angelaAceroh/Robotica-2026/Ensabladores/Ensamblador 3 /Electrónica/Diagrama_montaje_electrico.jpeg

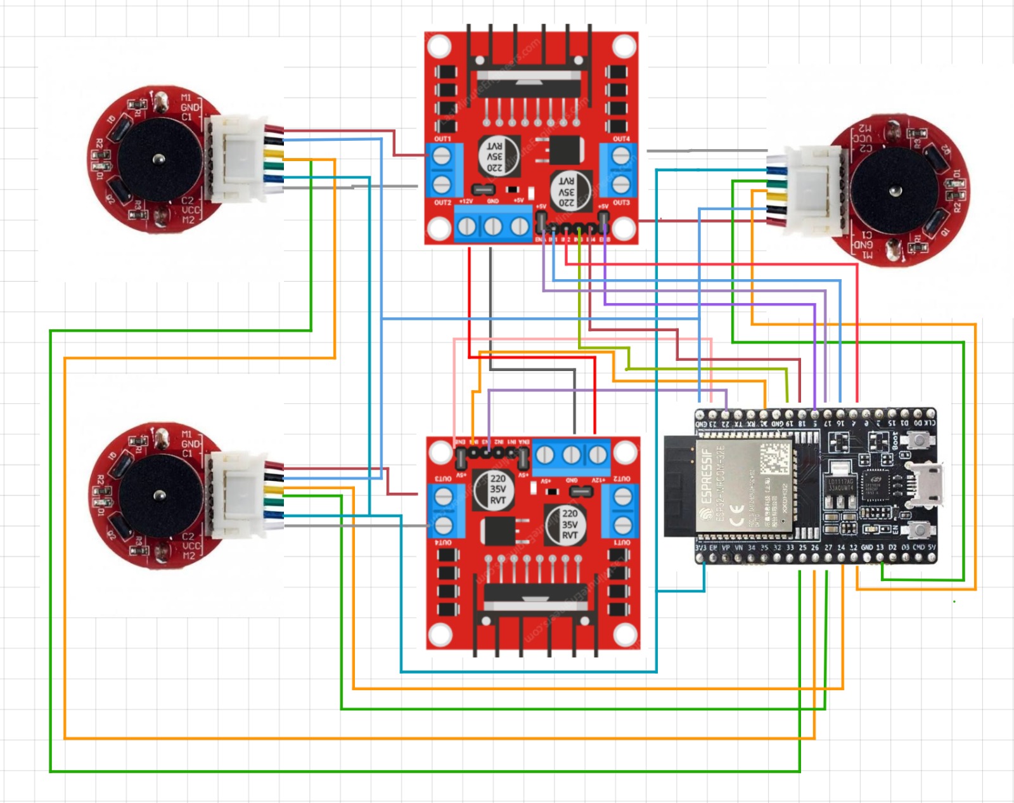
Ensabladores/Ensamblador 3 /Electrónica/Diagrama_montaje_electrico.jpeg
