angelaAceroh/Robotica-2026/Ensabladores/Ensamblador 2/SCARA/Documentacion/DIAGRAMAS/1)DIAGRAMA INDIVIDUAL.jpeg

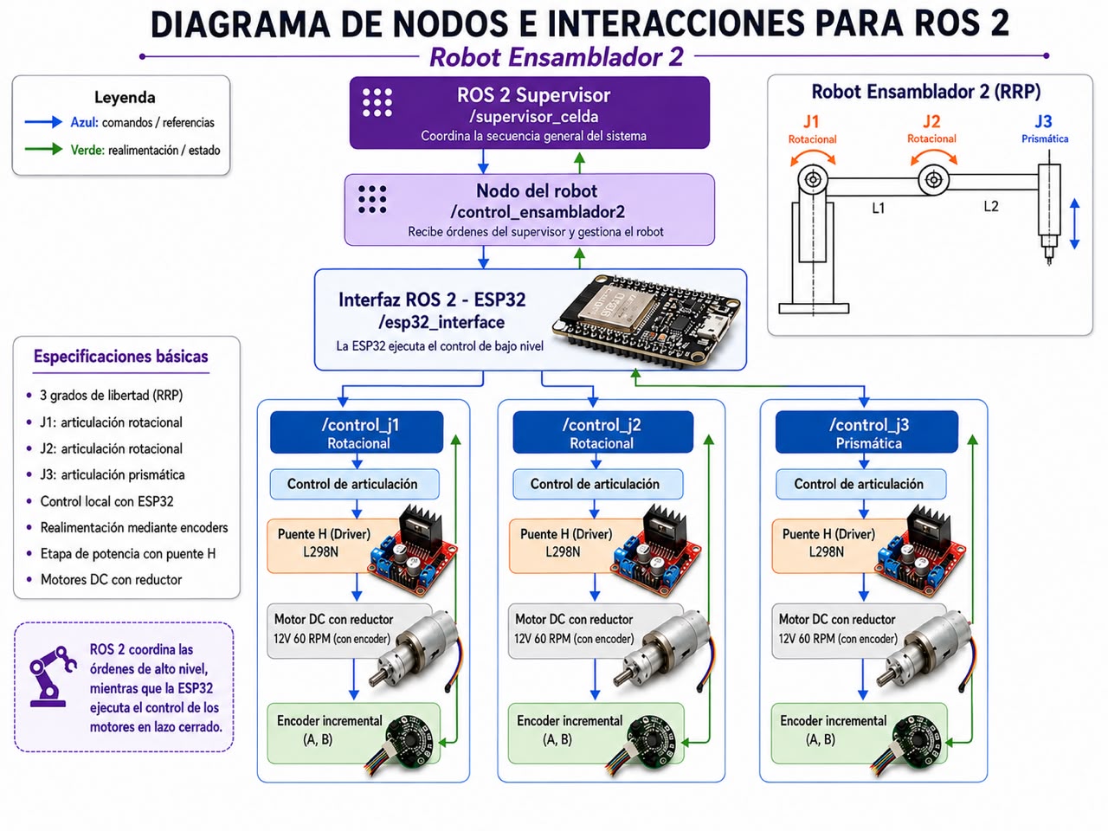
Ensabladores/Ensamblador 2/SCARA/Documentacion/DIAGRAMAS/1)DIAGRAMA INDIVIDUAL.jpeg
