angelaAceroh/Robotica-2026/README.md

# Robotica-2026
Info de la plata de robótica 2026-2
