angelaAceroh/Robotica-2026/Ensabladores/Ensamblador 1/EnsamblajeURDF/meshes/Gripper_Link.STL

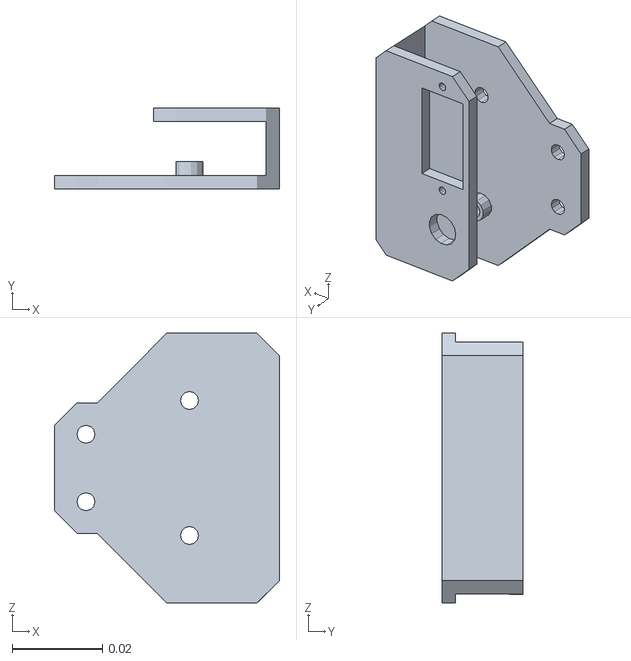
[picture p17: CAD file, 2026-10-02]
Ensabladores/Ensamblador 1/EnsamblajeURDF/meshes/Gripper_Link.STL
0.05 x 0.0181 x 0.06
