angelaAceroh/Robotica-2026/Ensabladores/Ensamblador 3 /Software/src/scara_urdf/meshes/Simon.STL

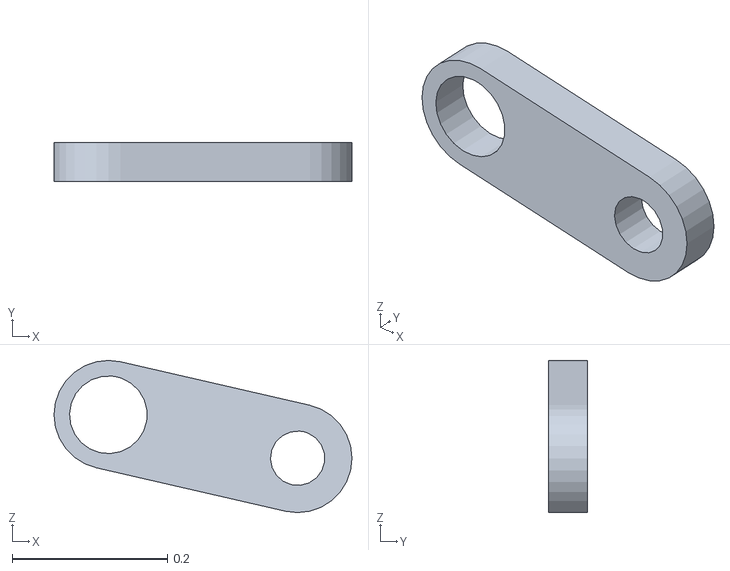
[picture p18: CAD file, 2026-10-02]
Ensabladores/Ensamblador 3 /Software/src/scara_urdf/meshes/Simon.STL
0.384 x 0.05 x 0.196
