angelaAceroh/Robotica-2026/Ensabladores/Ensamblador 1/EnsamblajeURDF/meshes/sopoizquierdo_Link.STL

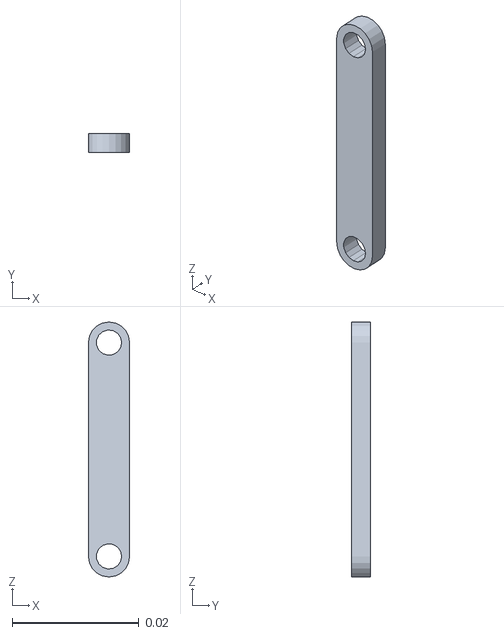
[picture p19: CAD file, 2026-10-02]
Ensabladores/Ensamblador 1/EnsamblajeURDF/meshes/sopoizquierdo_Link.STL
0.0065 x 0.003 x 0.0403
