angelaAceroh/Robotica-2026/Ensabladores/Ensamblador 3 /Mecánica/Simon1.SLDPRT

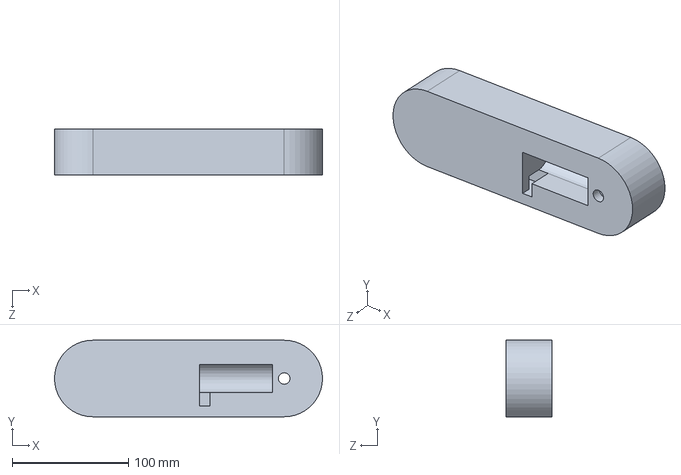
[picture p20: CAD file, 2026-08-21]
Ensabladores/Ensamblador 3 /Mecánica/Simon1.SLDPRT
231.0 x 66.0 x 40.0 mm
