angelaAceroh/Robotica-2026/Ensabladores/Ensamblador 3 /Software/src/scara_urdf/meshes/Teodoro.STL

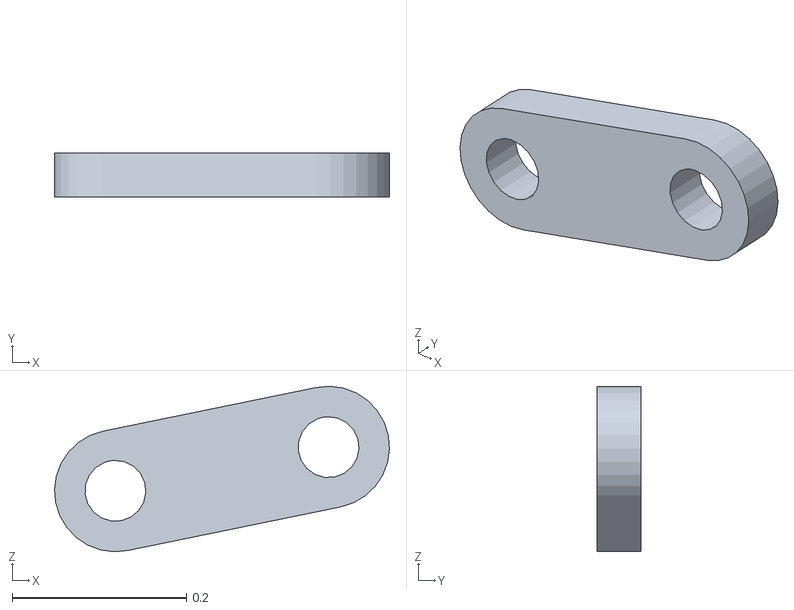
[picture p21: CAD file, 2026-10-02]
Ensabladores/Ensamblador 3 /Software/src/scara_urdf/meshes/Teodoro.STL
0.385 x 0.05 x 0.19
