angelaAceroh/Robotica-2026/Ensabladores/Ensamblador 1/EnsamblajeURDF/meshes/Eje_Principal_link.STL

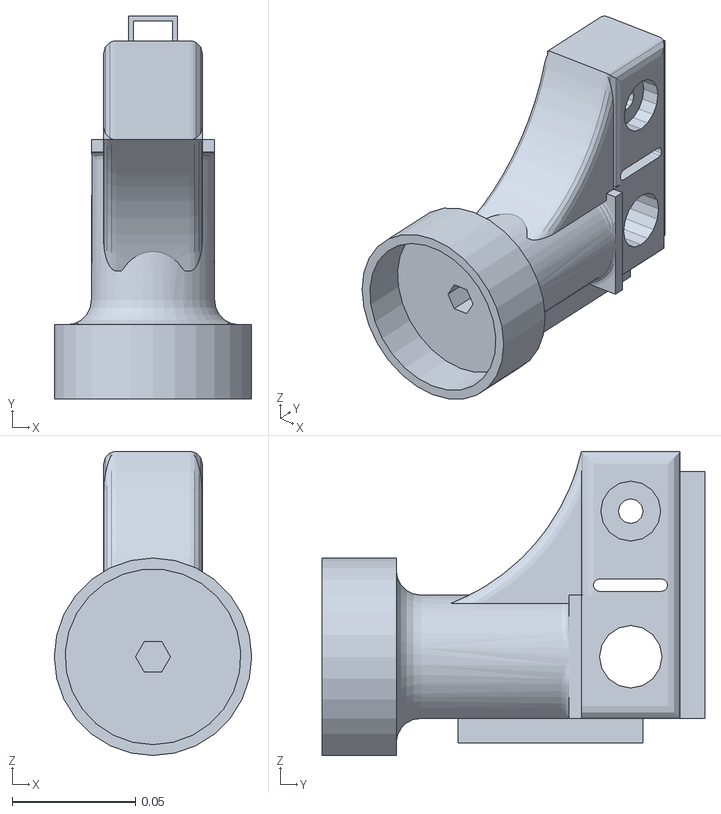
[picture p22: CAD file, 2026-10-02]
Ensabladores/Ensamblador 1/EnsamblajeURDF/meshes/Eje_Principal_link.STL
0.08 x 0.155 x 0.123
