angelaAceroh/Robotica-2026/Ensabladores/Ensamblador 3 /Mecánica/Teodoro1.SLDPRT

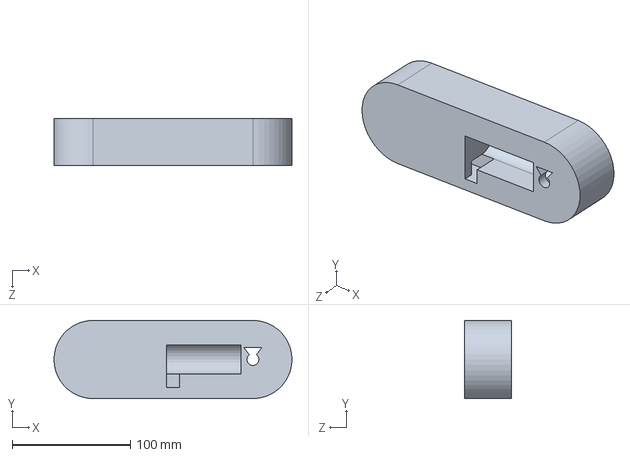
[picture p23: CAD file, 2026-08-21]
Ensabladores/Ensamblador 3 /Mecánica/Teodoro1.SLDPRT
201.0 x 66.0 x 40.0 mm
