angelaAceroh/Robotica-2026/Ensabladores/Ensamblador 3 /Software/src/scara_urdf/meshes/Dave.STL

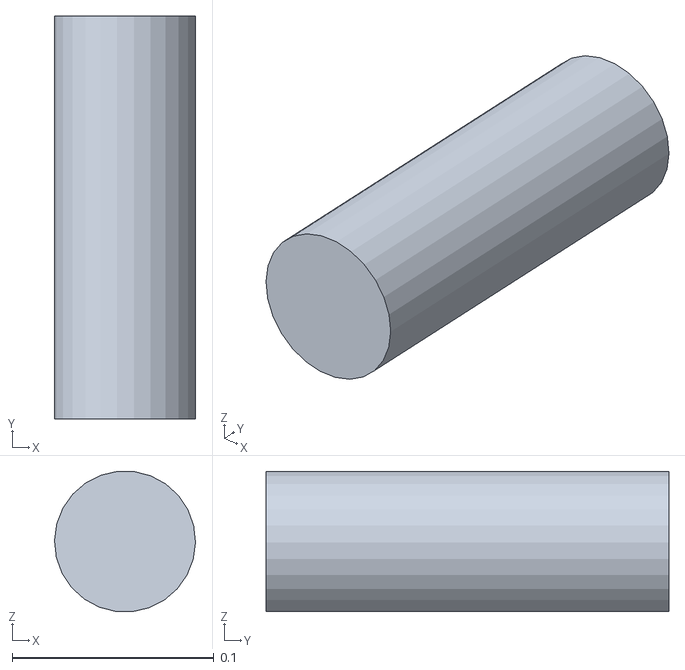
[picture p24: CAD file, 2026-10-02]
Ensabladores/Ensamblador 3 /Software/src/scara_urdf/meshes/Dave.STL
0.07 x 0.2 x 0.0696
