angelaAceroh/Robotica-2026/Ensabladores/Ensamblador 1/EnsamblajeURDF/meshes/Engraizquierdo_Link.STL

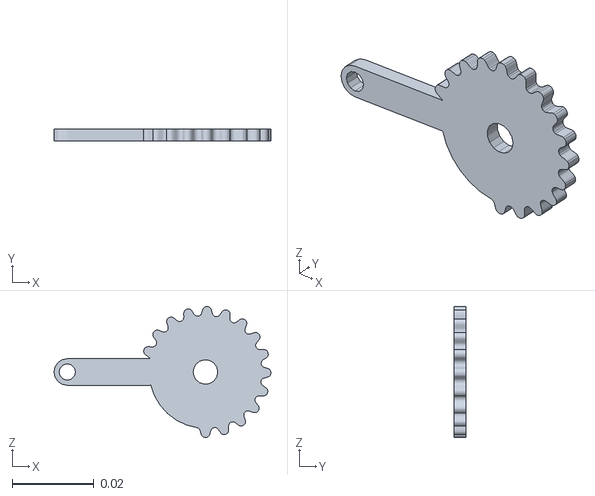
[picture p25: CAD file, 2026-10-02]
Ensabladores/Ensamblador 1/EnsamblajeURDF/meshes/Engraizquierdo_Link.STL
0.053 x 0.003 x 0.032
