angelaAceroh/Robotica-2026/Ensabladores/Ensamblador 3 /Mecánica/Dave1.SLDPRT

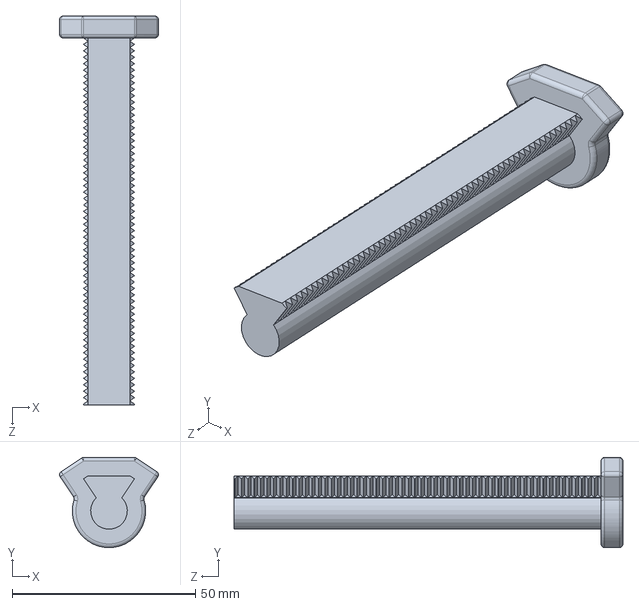
[picture p26: CAD file, 2026-08-21]
Ensabladores/Ensamblador 3 /Mecánica/Dave1.SLDPRT
27.0 x 24.6 x 106.0 mm
