angelaAceroh/Robotica-2026/Ensabladores/Ensamblador 3 /Software/src/scara_urdf/meshes/Ian.STL

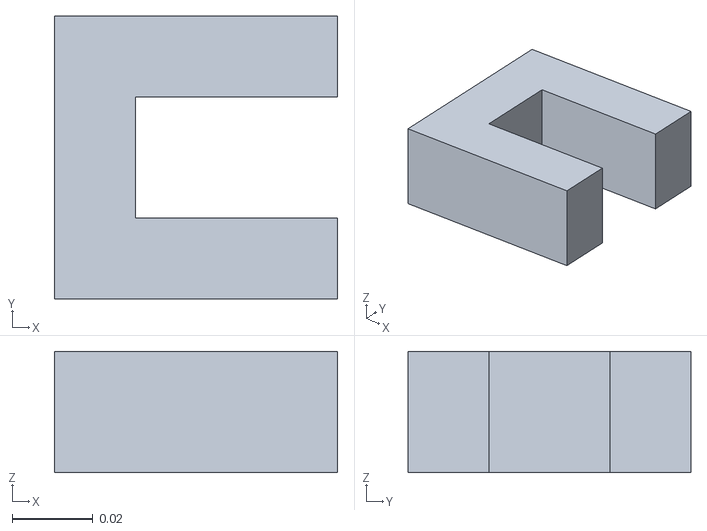
[picture p27: CAD file, 2026-10-02]
Ensabladores/Ensamblador 3 /Software/src/scara_urdf/meshes/Ian.STL
0.07 x 0.07 x 0.03
