angelaAceroh/Robotica-2026/Ensabladores/Ensamblador 1/EnsamblajeURDF/meshes/braerecho_Link.STL

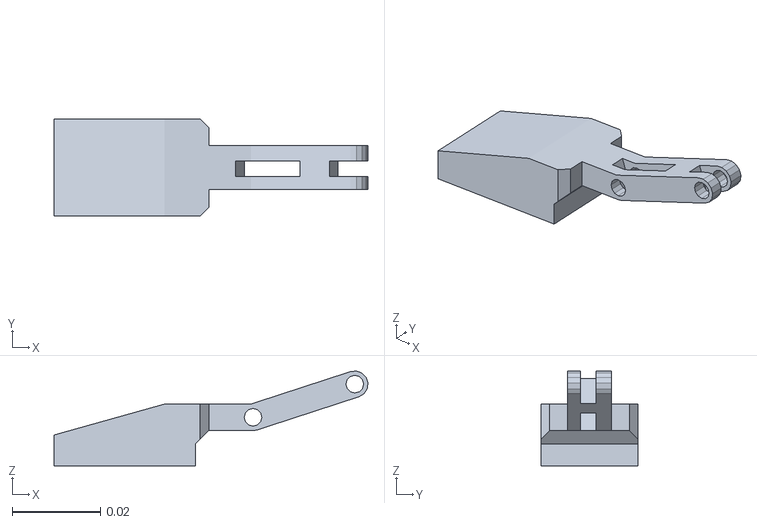
[picture p28: CAD file, 2026-10-02]
Ensabladores/Ensamblador 1/EnsamblajeURDF/meshes/braerecho_Link.STL
0.071 x 0.022 x 0.0215
