angelaAceroh/Robotica-2026/Ensabladores/Ensamblador 3 /Mecánica/tapa electronica.SLDPRT

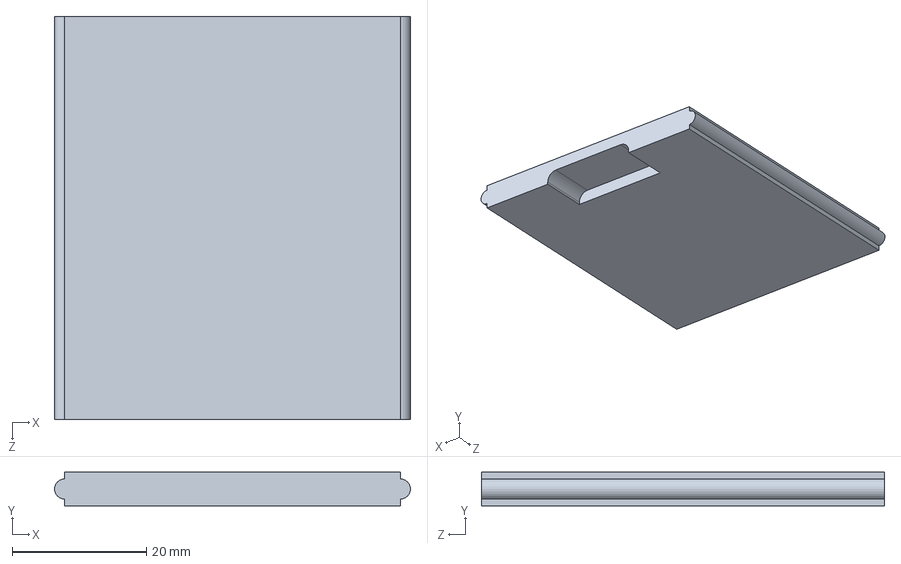
[picture p29: CAD file, 2026-08-21]
Ensabladores/Ensamblador 3 /Mecánica/tapa electronica.SLDPRT
53.0 x 5.00 x 60.0 mm
