angelaAceroh/Robotica-2026/Ensabladores/Ensamblador 3 /Software/src/scara_urdf/meshes/Alvin.STL

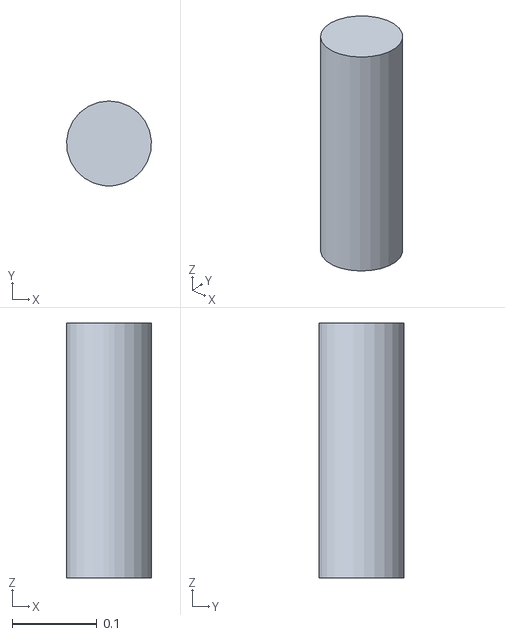
[picture p30: CAD file, 2026-10-02]
Ensabladores/Ensamblador 3 /Software/src/scara_urdf/meshes/Alvin.STL
0.0998 x 0.1 x 0.3
