angelaAceroh/Robotica-2026/Ensabladores/Ensamblador 3 /Mecánica/Alvin1.SLDPRT

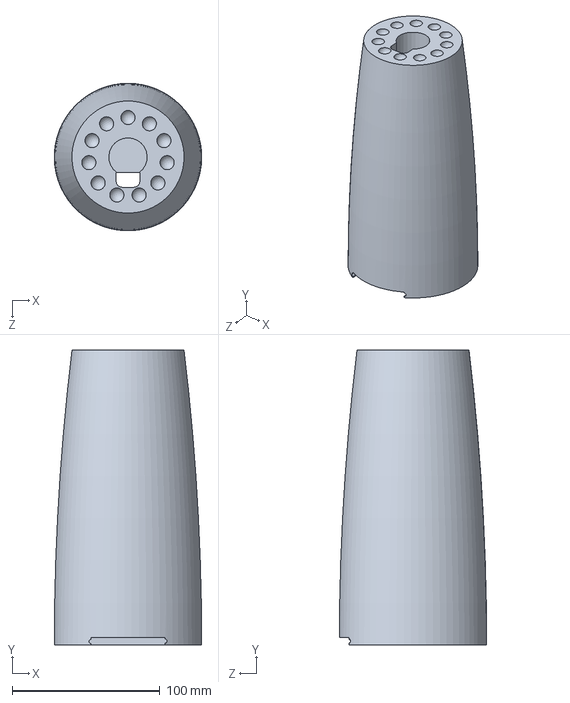
[picture p32: CAD file, 2026-08-21]
Ensabladores/Ensamblador 3 /Mecánica/Alvin1.SLDPRT
100.0 x 200.0 x 99.9 mm
