angelaAceroh/Robotica-2026/Ensabladores/Ensamblador 1/EnsamblajeURDF/meshes/Eje_largo_link.STL

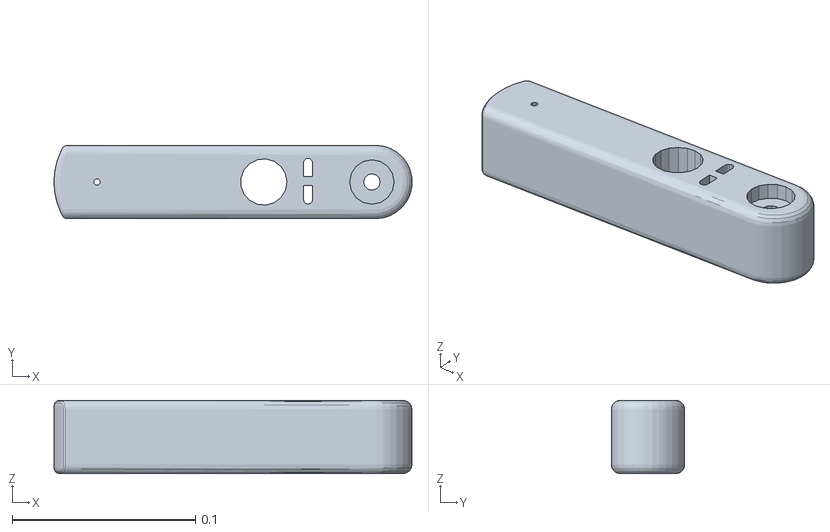
[picture p33: CAD file, 2026-10-02]
Ensabladores/Ensamblador 1/EnsamblajeURDF/meshes/Eje_largo_link.STL
0.195 x 0.04 x 0.04
