angelaAceroh/Robotica-2026/Ensabladores/Ensamblador 1/EnsamblajeURDF/meshes/Eje_final_link.STL

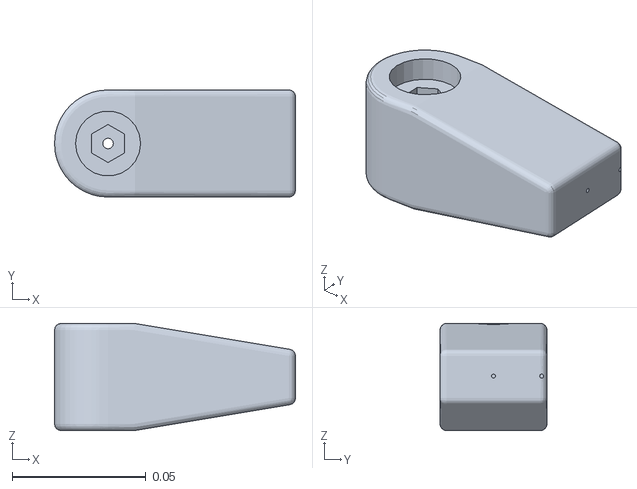
[picture p34: CAD file, 2026-10-02]
Ensabladores/Ensamblador 1/EnsamblajeURDF/meshes/Eje_final_link.STL
0.09 x 0.04 x 0.04
