angelaAceroh/Robotica-2026/Ensabladores/Ensamblador 3 /Mecánica/Ensamblaje1.SLDASM

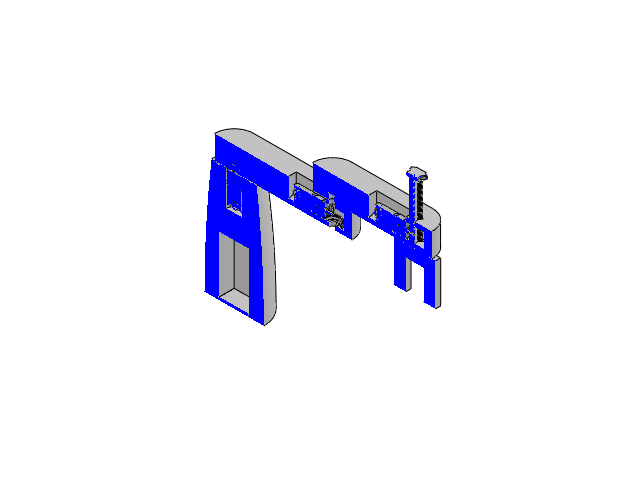
[picture p35: CAD file, 2026-08-21]
Ensabladores/Ensamblador 3 /Mecánica/Ensamblaje1.SLDASM
Alvin1
tapa electronica
JGA25-370 - JGA25-370 x 3
Teodoro1
Simon1
engranajeMotorGrua2Ext
Dave1
