angelaAceroh/Robotica-2026/(list of files, cad)

Other CAD files:
Ensabladores/Ensamblador 1/EnsamblajeURDF/meshes/Engraderecho_Link.STL
Ensabladores/Ensamblador 1/EnsamblajeURDF/meshes/sopoderecho_Link.STL
Ensabladores/Ensamblador 1/EnsamblajeURDF/meshes/braizquierdo_Link.STL
Ensabladores/Ensamblador 3 /Mecánica/Ensamblaje1 - copia.SLDDRW
Ensabladores/Ensamblador 3 /Mecánica/Ensamblaje1.SLDDRW
