angelaAceroh/Robotica-2026/Ensabladores/Ensamblador 3 /Software/README

En esta carpeta se encuentra tdod el material relacionado al uso de ROS, GAZEBO, y comunaciocon entre los ndos, asi como la interfaz y los diagramas.
