angelaAceroh/Robotica-2026/Ensabladores/Ensamblador 3 /Mecánica/README

En esta carpeta se encuentra todo el material con respecto a la mecánica y distribucon del robot
