angelaAceroh/Robotica-2026/Ensabladores/Ensamblador 3 /Software/build/scara_urdf/install_manifest.txt

/home/sergio/ros2_ws/install/scara_urdf/share/scara_urdf/config/joint_names_scara_urdf.yaml
/home/sergio/ros2_ws/install/scara_urdf/share/scara_urdf/launch/gazebo.launch.py
/home/sergio/ros2_ws/install/scara_urdf/share/scara_urdf/launch/display.launch.py
/home/sergio/ros2_ws/install/scara_urdf/share/scara_urdf/meshes/Ian.STL
/home/sergio/ros2_ws/install/scara_urdf/share/scara_urdf/meshes/Dave.STL
/home/sergio/ros2_ws/install/scara_urdf/share/scara_urdf/meshes/Alvin.STL
/home/sergio/ros2_ws/install/scara_urdf/share/scara_urdf/meshes/Simon.STL
/home/sergio/ros2_ws/install/scara_urdf/share/scara_urdf/meshes/Teodoro.STL
/home/sergio/ros2_ws/install/scara_urdf/share/scara_urdf/rviz/scara.rviz
/home/sergio/ros2_ws/install/scara_urdf/share/scara_urdf/rviz/urdf.rviz
/home/sergio/ros2_ws/install/scara_urdf/share/scara_urdf/urdf/scara_urdf.urdf
/home/sergio/ros2_ws/install/scara_urdf/share/scara_urdf/urdf/scara_urdf_gz.urdf
/home/sergio/ros2_ws/install/scara_urdf/share/scara_urdf/environment/gz_resource_path.dsv
/home/sergio/ros2_ws/install/scara_urdf/share/ament_index/resource_index/package_run_dependencies/scara_urdf
/home/sergio/ros2_ws/install/scara_urdf/share/ament_index/resource_index/parent_prefix_path/scara_urdf
/home/sergio/ros2_ws/install/scara_urdf/share/scara_urdf/environment/ament_prefix_path.sh
/home/sergio/ros2_ws/install/scara_urdf/share/scara_urdf/environment/ament_prefix_path.dsv
/home/sergio/ros2_ws/install/scara_urdf/share/scara_urdf/environment/path.sh
/home/sergio/ros2_ws/install/scara_urdf/share/scara_urdf/environment/path.dsv
/home/sergio/ros2_ws/install/scara_urdf/share/scara_urdf/local_setup.bash
/home/sergio/ros2_ws/install/scara_urdf/share/scara_urdf/local_setup.fish
/home/sergio/ros2_ws/install/scara_urdf/share/scara_urdf/local_setup.sh
/home/sergio/ros2_ws/install/scara_urdf/share/scara_urdf/local_setup.zsh
/home/sergio/ros2_ws/install/scara_urdf/share/scara_urdf/local_setup.dsv
/home/sergio/ros2_ws/install/scara_urdf/share/scara_urdf/package.dsv
/home/sergio/ros2_ws/install/scara_urdf/share/ament_index/resource_index/packages/scara_urdf
/home/sergio/ros2_ws/install/scara_urdf/share/scara_urdf/cmake/scara_urdfConfig.cmake
/home/sergio/ros2_ws/install/scara_urdf/share/scara_urdf/cmake/scara_urdfConfig-version.cmake
/home/sergio/ros2_ws/install/scara_urdf/share/scara_urdf/package.xml
