angelaAceroh/Robotica-2026/Ensabladores/Ensamblador 2/SCARA/Documentacion/Diagrama de nodos/6)DIAGRAMA DE NODOS E INTERACCIONES PARA ROS2.html

# Diagrama de nodos e interacciones para ROS 2 — Ensamblador 2

En esta arquitectura, ROS 2 coordina la celda mediante un nodo supervisor. Para el robot Ensamblador 2, el nivel de alto nivel se integra con el nivel físico: ESP32 para control local, puentes H como etapa de potencia, motores DC con encoder para realimentación y una configuración mecánica RRP de 3 grados de libertad. Las dimensiones mostradas se actualizaron con el plano mecánico definitivo.

Nodo central: /supervisor_celda Comandos: supervisor → robot Estados: robot → supervisor

### Especificaciones clave de E2

- 3 GDL tipo RRP: J1 rotacional, J2 rotacional, J3 prismática.
- Control local mediante ESP32.
- Realimentación mediante encoders de los motores.
- Etapa de potencia mediante puente H.
- Longitud total en planta: 489,97 mm.
- Altura máxima en vista lateral: 288,50 mm.
- Ancho frontal de base: 140,00 mm.
- Plano: A3 · escala 1:5 · cotas en mm.

## Arquitectura ROS 2 de la celda

Haz clic sobre cualquier nodo para ver su función, mensajes e interacción. El nodo de E2 fue ampliado con su arquitectura interna de control y hardware.

/supervisor_celda

Nodo Supervisor Central · Coordina toda la secuencia

Orden / comando Estado / confirmación

T1

### /nodo_t1

Transportador 1
P0 → P1 → P2

/t1/comando

/t1/estado

E1

### /nodo_e1

Ensamblador 1
Opera en P1

/e1/comando

/e1/estado

E2

### /nodo_e2

Ensamblador 2
Opera en P2 · RRP 3 GDL

/e2/comando

/e2/estado

T2

### /nodo_t2

Transportador 2
P2 → P3 → P4

/t2/comando

/t2/estado

E3

### /nodo_e3

Ensamblador 3
Opera en P3

/e3/comando

/e3/estado

Supervisor → Robots

publica órdenes en /t1/comando/e1/comando/e2/comando/t2/comando/e3/comando

Robots → Supervisor

publican estados en /t1/estado/e1/estado/e2/estado/t2/estado/e3/estado

## Arquitectura interna del Ensamblador 2

Configuración mecánica correcta: RRP — J1 rotacional, J2 rotacional y J3 prismática.

En E2, ROS 2 define la tarea y la referencia general. La ESP32 realiza el control de bajo nivel de las tres articulaciones, usando encoders para realimentación y puentes H para accionar los motores.

#### ESP32

Microcontrolador que ejecuta el control local del Ensamblador 2, recibe referencias desde ROS 2 y procesa la realimentación de encoders.

#### Puente H

Etapa de potencia para cada motor. Permite invertir el sentido de giro y entregar la corriente necesaria que la ESP32 no puede suministrar directamente.

Motor con encoder

#### Motor DC con encoder

Motorreductor JGA25-370 de 12 V y 60 RPM con encoder, empleado para accionar las articulaciones y medir movimiento/velocidad.

#### Encoder / realimentación

La señal del encoder retorna a la ESP32 para cerrar el lazo de control y corregir la posición o velocidad de cada articulación.

Plano mecánico actualizado del Ensamblador 2

- Configuración funcional: RRP — 2 articulaciones rotacionales y 1 prismática.
- Longitud total indicada en planta: 489,97 mm.
- Cotas longitudinales destacadas: 200,00 mm; 138,00 mm; 128,85 mm.
- Altura máxima indicada: 288,50 mm.
- Altura en vista frontal: 240,58 mm.
- Ancho de base en vista frontal: 140,00 mm.
- Otras cotas del conjunto: 60,00; 55,00; 45,00; 39,00 y 80,45 mm.
- Diámetro indicado: Ø24,50 mm.
- Material indicado en el plano: PLA.
- Escala: 1:5 · formato A3.

ROS 2Supervisor y referencias de tarea

/esp32_interfaceInterfaz ROS 2 – ESP32

ESP32Control local J1, J2 y J3

HardwarePuente H + Motor + Encoder

#### J1 — Rotacional

Controla la primera rotación del robot. Su referencia viene desde la ESP32 y se corrige con el encoder.

ESP32 → Control J1 → Puente H → Motor → J1 rotacional ↺ Encoder → ESP32

#### J2 — Rotacional

Controla la segunda rotación del brazo y permite orientar el siguiente eslabón dentro del plano de trabajo.

ESP32 → Control J2 → Puente H → Motor → J2 rotacional ↺ Encoder → ESP32

#### J3 — Prismática

Controla el desplazamiento prismático del efector final, permitiendo el movimiento lineal de la tercera articulación.

ESP32 → Control J3 → Puente H → Motor → J3 prismática ↺ Encoder → ESP32

## Plano mecánico actualizado del Ensamblador 2

El plano mecánico definitivo sustituye las dimensiones conceptuales usadas anteriormente. Las cotas se expresan en milímetros y el documento está presentado en formato A3 con escala 1:5.

#### Dimensiones principales

489,97 mm — longitud total indicada en planta.

288,50 mm — altura máxima indicada en vista lateral.

240,58 mm — altura indicada en vista frontal.

140,00 mm — ancho de la base en vista frontal.

200,00 / 138,00 / 128,85 mm — cotas longitudinales internas del conjunto.

60,00 / 55,00 / 45,00 / 39,00 / 80,45 mm — cotas verticales y offsets mostrados.

Ø24,50 mm — diámetro indicado en la vista superior.

Material: PLA · Escala: 1:5 · Formato: A3.

## Secuencia de interacción

Esta es la lógica que sigue el supervisor para coordinar el proceso completo.

1

#### T1 recibe la primera orden

El supervisor ordena a T1 mover la caja desde P0 hasta P1. T1 confirma cuando llega.

2

#### E1 realiza el primer ensamble

Cuando T1 reporta que la caja está en P1, el supervisor habilita E1. E1 informa cuando termina.

3

#### T1 lleva la caja a P2

El supervisor vuelve a ordenar a T1 que transporte la caja de P1 a P2.

4

#### E2 realiza el segundo ensamble

E2 recibe la autorización para trabajar en P2. Internamente, la ESP32 ejecuta el control de sus tres articulaciones y E2 reporta cuando el ensamble terminó.

5

#### T2 recibe la caja

El supervisor ordena a T2 mover la caja desde P2 hasta P3.

6

#### E3 completa el ensamble

E3 trabaja sobre la caja en P3 y confirma que la caja final contiene 9 chocolates.

7

#### T2 lleva la caja a salida

Finalmente, T2 mueve la caja terminada desde P3 hasta P4 y reporta proceso finalizado.

## Conceptos ROS 2 y de control usados en el diagrama

Definiciones cortas para que puedas explicarlo en la sustentación.

#### Nodo

Es un programa que cumple una tarea específica. Por ejemplo, E2 tiene un nodo encargado de recibir órdenes y ejecutar la lógica del robot.

#### Topic

Es el canal por donde se envían mensajes, por ejemplo /e2/comando o /e2/estado.

#### Publisher

Es quien envía el mensaje. El supervisor publica comandos; el robot publica estados.

#### Subscriber

Es quien recibe el mensaje. Cada robot se suscribe a su topic de comandos.

#### ESP32

Microcontrolador que realiza el control local de los motores y procesa la realimentación de encoders.

#### Encoder

Sensor acoplado al motor que informa posición o velocidad para cerrar el lazo de control.

#### Puente H

Etapa de potencia que permite accionar el motor en ambos sentidos y con la corriente necesaria.

#### Control de bajo nivel

Control local de J1, J2 y J3 ejecutado por la ESP32, usando realimentación y actuando sobre los motores.

Arquitectura conceptual ROS 2 del Ensamblador 2, integrada con sus especificaciones físicas, eléctricas y de control.

×

#### Función

#### Recibe

#### Envía

#### Topics / especificación

### Interacción resumida
