angelaAceroh/Robotica-2026/Ensabladores/Ensamblador 3 /Control/README

En esta carpte se encuenta la ifnromacion relacionada con la cienamtica direca, inverssa, difernecial , trayectroias y control
