angelaAceroh/Robotica-2026/Ensabladores/Ensamblador 3 /Admin/README

En esta carpeta se encucentran lso archivos realcionados con las actas y con los avances de la cartilla
