angelaAceroh/Robotica-2026/Ensabladores/Ensamblador 3 /Electrónica/README

en esta carpeta se encuentra todo el materal con respecto a la electróncia utililizada
