angelaAceroh/Robotica-2026/Ensabladores/Ensamblador 2/SCARA/Documentacion/DIAGRAMAS/1)DIAGRAMA EN BLOQUES DEL SISTEMA COMPLETO.html

# Diagrama en Bloques del Sistema de Ensamble con ROS 2

Arquitectura general de una celda de ensamble con 3 ensambladores (E1, E2, E3), 2 transportadores (T1, T2) y ROS 2 como supervisor central. La caja recorre las posiciones P0–P4 hasta completar un producto final con 9 chocolates.

ROS 2 = Supervisor central T1 y T2 = Transportadores E1, E2, E3 = Ensambladores Caja final = 9 chocolates Soportes preliminares = 100 mm

### Resumen del proceso

- T1 mueve la caja: P0 → P1 → P2.
- E1 ensambla en P1.
- E2 ensambla en P2.
- T2 mueve la caja: P2 → P3 → P4.
- E3 ensambla en P3.
- ROS 2 coordina órdenes, secuencia y estados.
- En P4 queda la caja final con 9 chocolates.

Celda

1.25 m × 1.25 m

Posiciones

P0 · P1 · P2 · P3 · P4

Soporte preliminar

100 mm

Producto final

9 chocolates

## Arquitectura general

Haz clic sobre cada robot para ver su función, comunicación y diagrama interno.

ROS 2 — Supervisor Central
Coordinación · Secuenciación · Supervisión · Comunicación

T1

### Transportador 1

P0 → P1

→

E1

### Ensamblador 1

Opera en P1

→

T1

### Transportador 1

P1 → P2

→

E2

### Ensamblador 2

Opera en P2

→

T2

### Transportador 2

P2 → P3

→

E3

### Ensamblador 3

Opera en P3

→

T2

### Transportador 2

P3 → P4

### Flujo físico de la caja

P0

Caja de entrada

T1 recoge

➜

P1

Ensamble 1

E1 actúa

➜

P2

Ensamble 2 / transferencia

E2 actúa

➜

P3

Ensamble 3

E3 actúa

➜

P4

Salida

T2 entrega

## Distribución de la planta y secuencia

Distribución actualizada de la planta de ensamble

Esta es la distribución actualizada de la planta, con la secuencia visual del movimiento de la caja, zonas de ensambladores y transportadores, reservorios y posiciones numeradas de la caja.

1

#### Inicio en P0

La caja inicia el proceso en la posición P0.

2

#### T1 lleva P0 → P1

T1 entrega la caja para el primer ensamble.

3

#### E1 trabaja en P1

E1 realiza el primer ensamble y confirma a ROS 2.

4

#### T1 lleva P1 → P2

La caja avanza hacia la segunda estación.

5

#### E2 trabaja en P2

E2 realiza el segundo ensamble. P2 también es punto de transferencia hacia T2.

6

#### T2 lleva P2 → P3

T2 lleva la caja a la tercera estación.

7

#### E3 completa el ensamble

E3 trabaja en P3 y completa la caja con 9 chocolates.

8

#### T2 lleva P3 → P4

La caja terminada queda disponible en la salida.

## Información importante del sistema

#### Dimensión de planta

Área máxima de 1.25 m × 1.25 m.

#### Caja elevada

La caja no debe tocar el piso; se propone soporte preliminar de 100 mm.

#### Actuación y sensado

Motores DC con reductor, drivers de potencia y encoders por articulación.

#### ROS 2

Coordina la secuencia, habilita operaciones y recibe estados de cada robot.

×

#### Función

#### Posiciones

#### Comunicación con ROS 2

#### Estados reportados

### Diagrama en bloques del robot
