angelaAceroh/Robotica-2026/Ensabladores/Ensamblador 2/SCARA/Documentacion/Diagrama de nodos/Diagramas de nodos.png

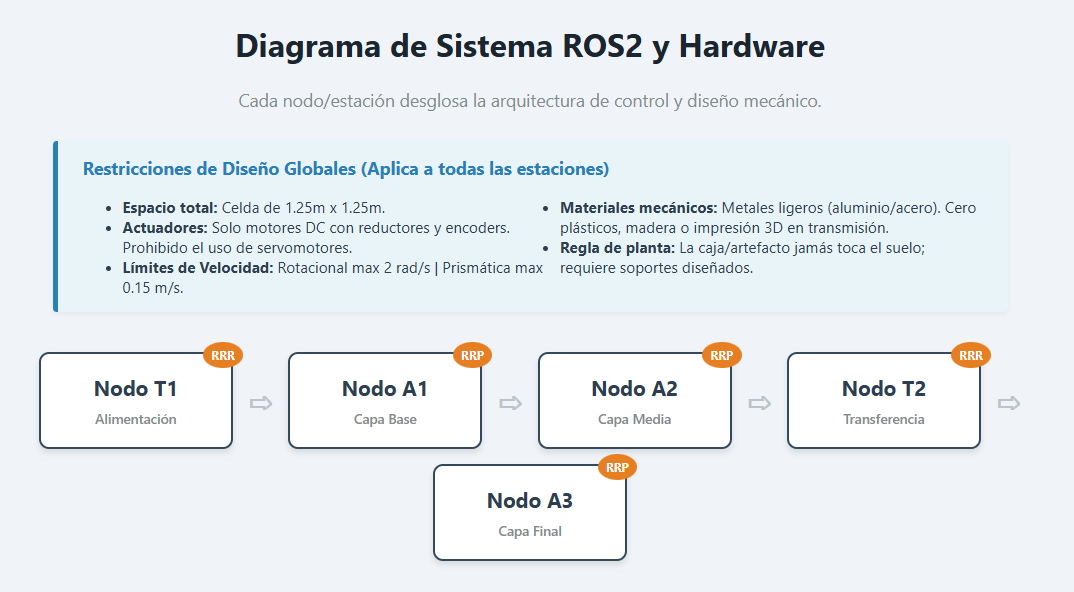
Ensabladores/Ensamblador 2/SCARA/Documentacion/Diagrama de nodos/Diagramas de nodos.png
