angelaAceroh/Robotica-2026/Ensabladores/Ensamblador 2/SCARA/Documentacion/Plano de planta/2)PLANO DE LA PLANTA (ENTORNO Y ELEMENTOS) CON DIMENSIONES.png

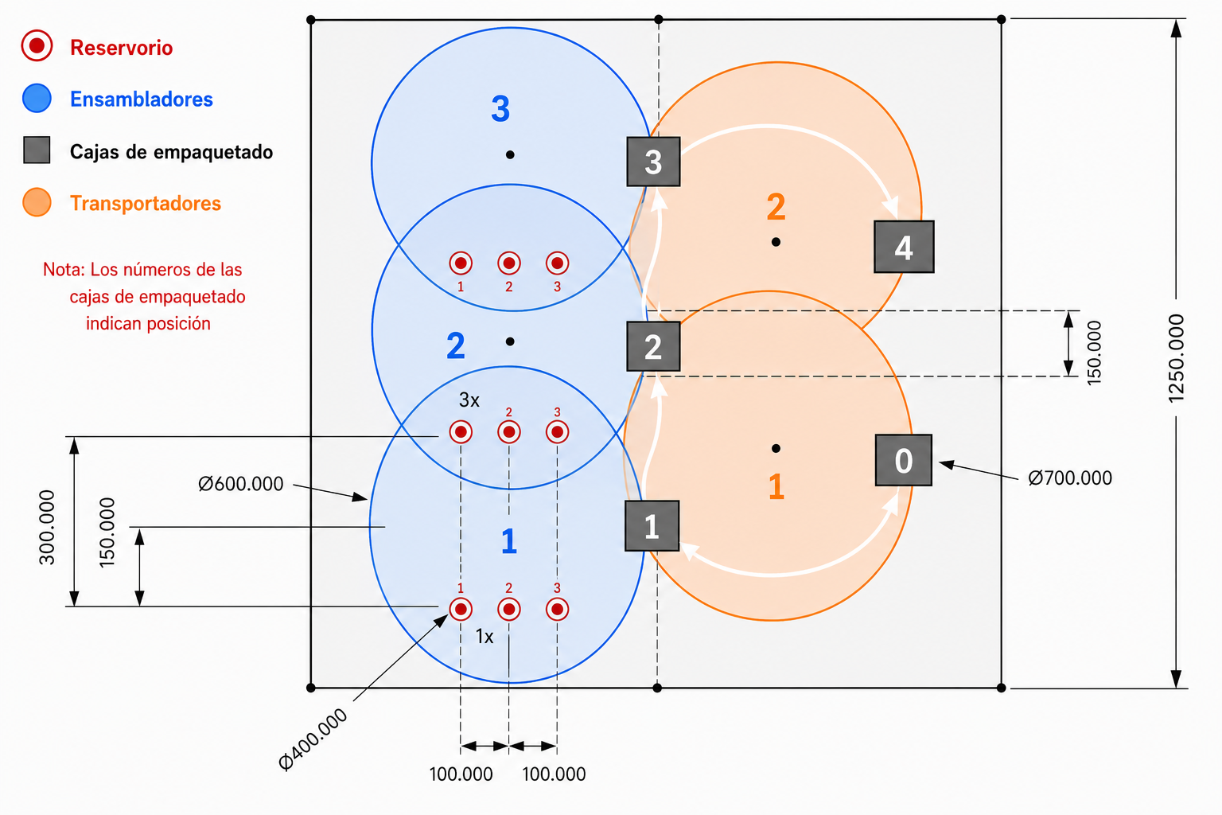
Ensabladores/Ensamblador 2/SCARA/Documentacion/Plano de planta/2)PLANO DE LA PLANTA (ENTORNO Y ELEMENTOS) CON DIMENSIONES.png
