angelaAceroh/Robotica-2026/Ensabladores/Ensamblador 3 /Control/Cinematica Directa a mano.jpeg

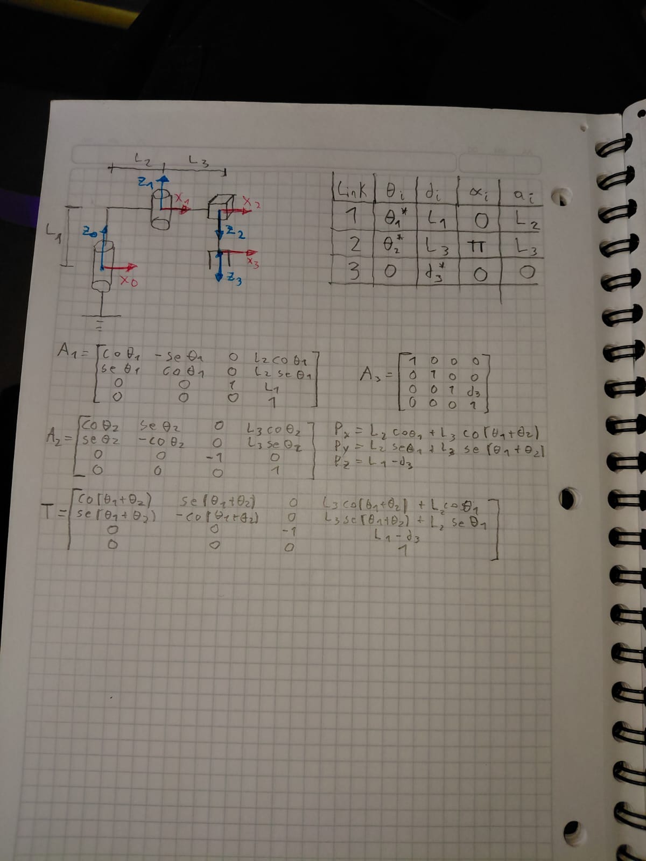
Ensabladores/Ensamblador 3 /Control/Cinematica Directa a mano.jpeg
