angelaAceroh/Robotica-2026/Ensabladores/Ensamblador 3 /Electrónica/diagrama_electrico_scara.png

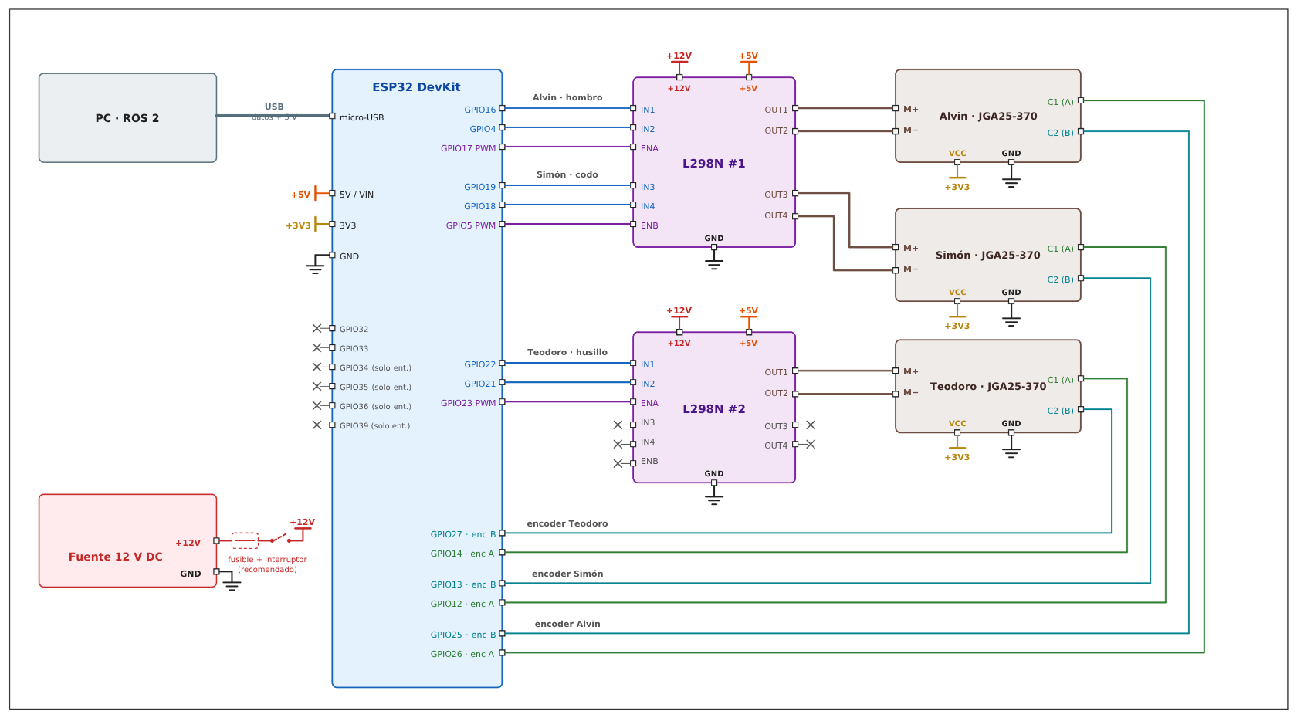
Ensabladores/Ensamblador 3 /Electrónica/diagrama_electrico_scara.png
