angelaAceroh/Robotica-2026/Ensabladores/Ensamblador 3 /Mecánica/plano Completo .png

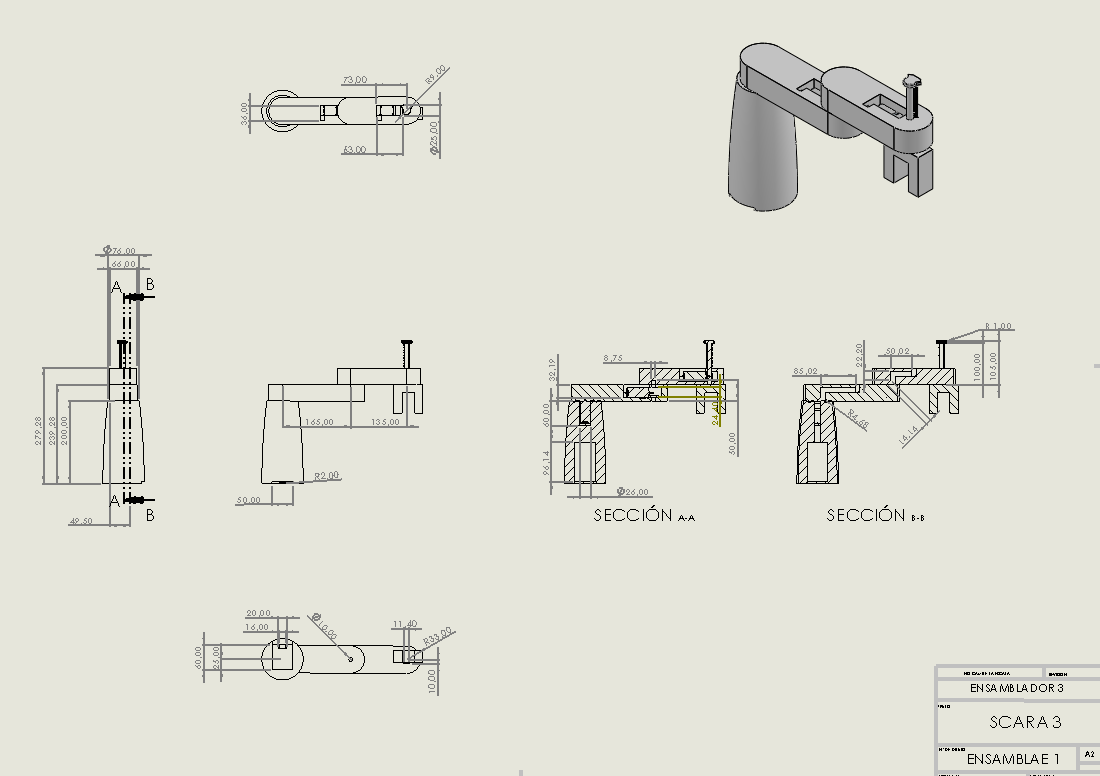
Ensabladores/Ensamblador 3 /Mecánica/plano Completo .png
