angelaAceroh/Robotica-2026/Transportadores/Transportador 1/Resultados/comparacion_cinematicas.csv

punto | obj_x_mm | obj_y_mm | obj_z_mm | dir_x_mm | dir_y_mm | dir_z_mm | dir_error_mm | inv_x_mm | inv_y_mm | inv_z_mm | inv_error_mm | qref_J1 | qref_J2 | qref_J3 | qci_J1 | qci_J2 | qci_J3 | postura_ci | soluciones | soluciones_validas
P1 home extendido | 490.36 | 0.00 | 342.65 | 490.36 | -0.00 | 342.29 | 0.362 | 490.36 | -0.00 | 342.29 | 0.356 | 0.000 | 0.000 | 0.000 | 0.000 | 0.000 | -0.000 | hombro_frente/codo_arriba | 1 | 1
P2 frente arriba | 417.82 | 0.00 | 293.80 | 417.73 | -0.00 | 293.78 | 0.093 | 417.72 | 0.00 | 293.64 | 0.193 | 0.000 | 40.000 | -70.000 | 0.000 | 40.000 | -70.000 | hombro_frente/codo_arriba | 2 | 2
P3 derecha media altura | 318.10 | 318.10 | 283.70 | 317.85 | 318.37 | 283.87 | 0.406 | 317.53 | 318.05 | 283.64 | 0.577 | 45.000 | 25.000 | -50.000 | 45.000 | 25.000 | -50.000 | hombro_frente/codo_arriba | 2 | 2
P4 izquierda alta | 180.54 | -312.70 | 278.80 | 180.13 | -312.83 | 278.81 | 0.432 | 180.12 | -312.83 | 278.81 | 0.432 | -60.000 | 55.000 | -95.000 | -60.000 | 55.000 | -95.000 | hombro_frente/codo_arriba | 4 | 2
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
