angelaAceroh/Robotica-2026/Transportadores/Transportador 1/Resultados/trayectoria_lineal.csv

k | s | obj_x_mm | obj_y_mm | obj_z_mm | ci_J1_deg | ci_J2_deg | ci_J3_deg | postura | soluciones | soluciones_validas | med_J1_deg | med_J2_deg | med_J3_deg | real_x_mm | real_y_mm | real_z_mm | error_mm | desvio_recta_mm | tau_J2_Nm | tau_J3_Nm | tau_J2_kgfcm | tau_J3_kgfcm | pct_nominal_J2 | pct_nominal_J3
1 | 0.0000 | 300.00 | -150.00 | 250.00 | -26.565 | 54.417 | -102.194 | hombro_frente/codo_arriba | 4 | 1 | -26.604 | 54.447 | -102.248 | 299.76 | -150.14 | 249.96 | 0.276 | 0.240 | 0.9747 | 0.4409 | 9.939 | 4.496 | 487.3 | 220.4
2 | 0.0909 | 300.00 | -122.73 | 250.00 | -22.249 | 57.442 | -106.526 | hombro_frente/codo_arriba | 4 | 1 | -22.241 | 57.439 | -106.533 | 299.99 | -122.67 | 249.96 | 0.068 | 0.039 | 0.9239 | 0.4298 | 9.421 | 4.382 | 461.9 | 214.9
3 | 0.1818 | 300.00 | -95.45 | 250.00 | -17.650 | 59.931 | -110.036 | hombro_frente/codo_arriba | 4 | 1 | -17.640 | 59.926 | -110.039 | 300.00 | -95.40 | 249.97 | 0.063 | 0.028 | 0.8809 | 0.4209 | 8.983 | 4.292 | 440.5 | 210.4
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
