angelaAceroh/Robotica-2026/Ensabladores/Ensamblador 1/ControlVelocidad/datos_experimento.csv

Tiempo_s | Distancia_cm | Angulo_deg
0.1291898 | 12.81 | -53.2
0.2591758 | 12.49 | -52.45
0.2597399 | 12.94 | -52.76
0.2600959 | 13.75 | -50.34
0.260572 | 12.69 | -51.83
0.2611458 | 13.34 | -51.44
0.2617196 | 12.95 | -51.79
0.2625503 | 12.89 | -50.91
0.2632363 | 12.78 | -51.35
0.2638243 | 13.62 | -50.78
0.2644255 | 14.45 | -50.56
0.2649571 | 13.64 | -50.56
0.2654512 | 12.69 | -50.38
0.265915 | 14.75 | -50.78
0.2663043 | 14.34 | -50.03
0.2666706 | 13.97 | -50.38
0.267013 | 14.79 | -49.72
0.2673754 | 14.24 | -50.38
0.2677099 | 13.36 | -49.9
0.2680369 | 15.39 | -50.34
0.2684218 | 13.94 | -50.34
0.26881 | 13.57 | -51.44
0.2699008 | 14.24 | -50.03
0.2716757 | 14.92 | -49.86
0.2724215 | 14.92 | -49.33
0.2729317 | 9.9 | -48.76
0.2733986 | 14.4 | -50.38
0.2738344 | 9.01 | -49.68
0.274269 | 9.91 | -51.13
0.2746679 | 15.15 | -50.74
0.2750635 | 14.24 | -51.31
0.2754897 | 15.57 | -50.56
0.2758983 | 14.09 | -51.13
0.2763064 | 15 | -51.83
0.2767317 | 14.63 | -51.57
0.2771523 | 15.15 | -51.75
0.2775922 | 15.71 | -51.48
0.2780004 | 14.96 | -51.83
0.2784069 | 14.72 | -51.13
0.2788209 | 15.29 | -52.32
0.279219 | 15.61 | -51.83
0.279624 | 15.35 | -51.97
0.2799829 | 15.43 | -52.45
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
