angelaAceroh/Robotica-2026/Ensabladores/Ensamblador 1/ControlVelocidad/datos_experimento_Arreglado.csv

Muestras | Distancia_cm | Angulo_deg | tiempo | Grados
0 | 12.81 | -53.2 | 0 | 36.8
1 | 12.49 | -52.45 | 0.005 | 37.55
2 | 12.94 | -52.76 | 0.01 | 37.24
3 | 13.75 | -50.34 | 0.015 | 39.66
4 | 12.69 | -51.83 | 0.02 | 38.17
5 | 13.34 | -51.44 | 0.025 | 38.56
6 | 12.95 | -51.79 | 0.03 | 38.21
7 | 12.89 | -50.91 | 0.035 | 39.09
8 | 12.78 | -51.35 | 0.04 | 38.65
9 | 13.62 | -50.78 | 0.045 | 39.22
10 | 14.45 | -50.56 | 0.05 | 39.44
11 | 13.64 | -50.56 | 0.055 | 39.44
12 | 12.69 | -50.38 | 0.06 | 39.62
13 | 14.75 | -50.78 | 0.065 | 39.22
14 | 14.34 | -50.03 | 0.07 | 39.97
15 | 13.97 | -50.38 | 0.075 | 39.62
16 | 14.79 | -49.72 | 0.08 | 40.28
17 | 14.24 | -50.38 | 0.085 | 39.62
18 | 13.36 | -49.9 | 0.09 | 40.1
19 | 15.39 | -50.34 | 0.095 | 39.66
20 | 13.94 | -50.34 | 0.1 | 39.66
21 | 13.57 | -51.44 | 0.105 | 38.56
22 | 14.24 | -50.03 | 0.11 | 39.97
23 | 14.92 | -49.86 | 0.115 | 40.14
24 | 14.92 | -49.33 | 0.12 | 40.67
25 | 9.9 | -48.76 | 0.125 | 41.24
26 | 14.4 | -50.38 | 0.13 | 39.62
27 | 9.01 | -49.68 | 0.135 | 40.32
28 | 9.91 | -51.13 | 0.14 | 38.87
29 | 15.15 | -50.74 | 0.145 | 39.26
30 | 14.24 | -51.31 | 0.15 | 38.69
31 | 15.57 | -50.56 | 0.155 | 39.44
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
