angelaAceroh/Robotica-2026/Ensabladores/Ensamblador 1/ControlVelocidad/datos_experimento_ref.csv

Tiempo_s | Distancia_cm | Angulo_deg | Vref_V | Angulo
23.155.887 | 13,08 | -57,94 | 3,3 | 32,06
30.377.944 | 12,4 | -59,22 | 3,3 | 30,78
30.701.477 | 12,45 | -58,69 | 3,3 | 31,31
30.959.867 | 12,37 | -59,39 | 3,3 | 30,61
31.255.961 | 12,03 | -58,3 | 3,3 | 31,7
31.343.752 | 12,06 | -58,08 | 3,3 | 31,92
3.136.951 | 12,19 | -58,21 | 3,3 | 31,79
31.383.247 | 11,97 | -58,69 | 3,3 | 31,31
31.391.364 | 12,45 | -59,48 | 3,3 | 30,52
31.399 | 12,32 | -57,68 | 3,3 | 32,32
31.407.335 | 12,27 | -57,11 | 3,3 | 32,89
31.416.534 | 11,1 | -57,5 | 3,3 | 32,5
31.424.635 | 11,7 | -58,52 | 3,3 | 31,48
31.431.991 | 12,13 | -57,59 | 3,3 | 32,41
31.439.606 | 11,31 | -57,59 | 3,3 | 32,41
31.446.965 | 11,29 | -57,68 | 3,3 | 32,32
31.454.453 | 12,03 | -58,08 | 3,3 | 31,92
31.462.177 | 10,92 | -57,94 | 3,3 | 32,06
31.469.565 | 11,38 | -57,99 | 3,3 | 32,01
31.476.732 | 2,96 | -32,76 | 3,3 | 57,24
31.484.214 | 11 | -56,23 | 3,3 | 33,77
31.491.716 | 11,06 | -55,97 | 3,3 | 34,03
31.502.993 | 10,85 | -57,24 | 3,3 | 32,76
31.529.867 | 10,55 | -57,15 | 3,3 | 32,85
31.538.592 | 10,67 | -57,59 | 3,3 | 32,41
31.545.984 | 10,67 | -57,11 | 3,3 | 32,89
31.553.195 | 11,15 | -56,71 | 3,3 | 33,29
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
