angelaAceroh/Robotica-2026/Ensabladores/Ensamblador 2/SCARA/Documentacion/Planos Mecánicos y eléctricos/PLANO MECANICO.pdf

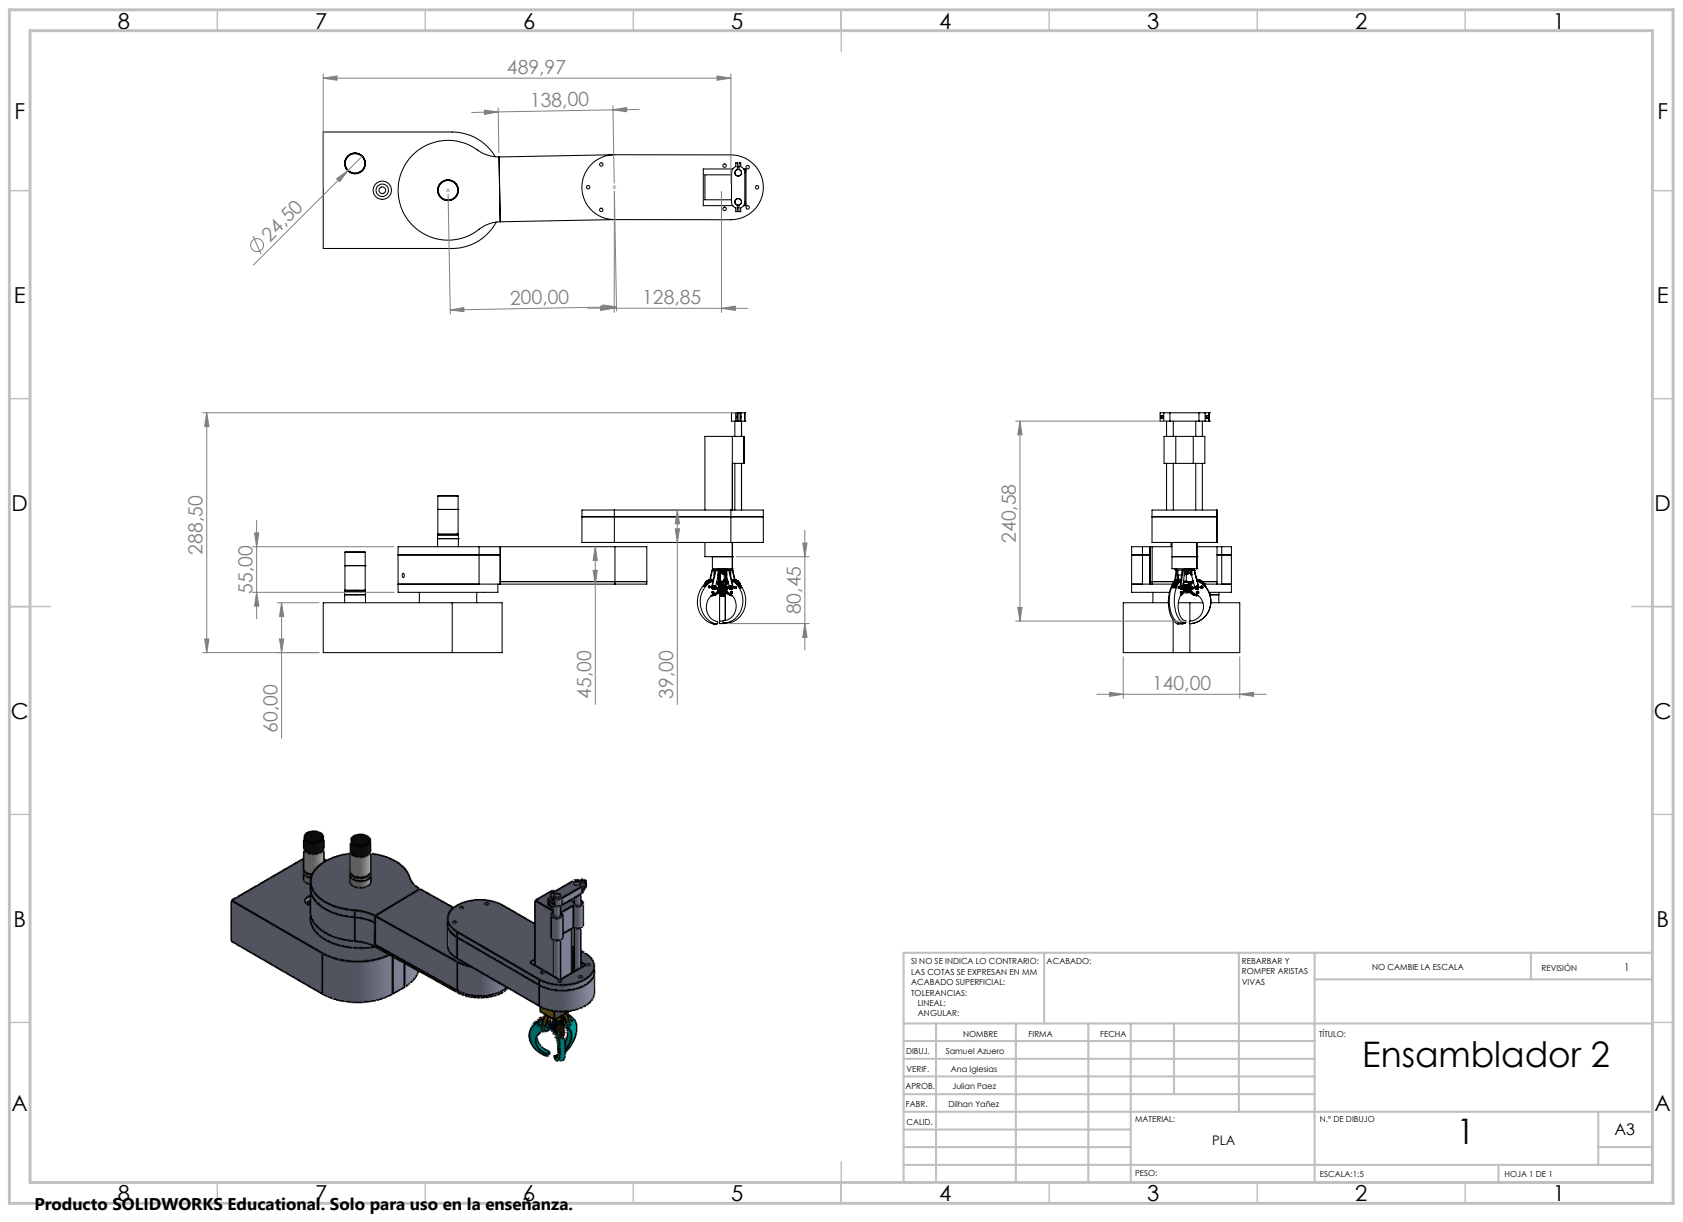
[picture p45: page 1]
ACABADO:; REBARBAR Y; ROMPER ARISTAS; NO CAMBIE LA ESCALA; REVISIÓN; ESCALA:1:5; HOJA 1 DE 1

SI NO SE INDICA LO CONTRARIO:
LAS COTAS SE EXPRESAN EN MM
ACABADO SUPERFICIAL:
TOLERANCIAS:
LINEAL:
ANGULAR:

NOMBRE | FIRMA | FECHA | | | | TÍTULO: Ensamblador 2

DIBUJ. | Samuel Azuero
VERIF. | Ana Iglesias
APROB. | Julian Paez
FABR. | Dilhan Yañez
CALID. | | | | MATERIAL: PLA | 1 N.º DE DIBUJO | A3

Producto SOLIDWORKS Educational. Solo para uso en la enseñanza.
