angelaAceroh/Robotica-2026/Ensabladores/Ensamblador 2/SCARA/Documentacion/Planos Mecánicos y eléctricos/PLANOS ELECTRICOS (2).PDF

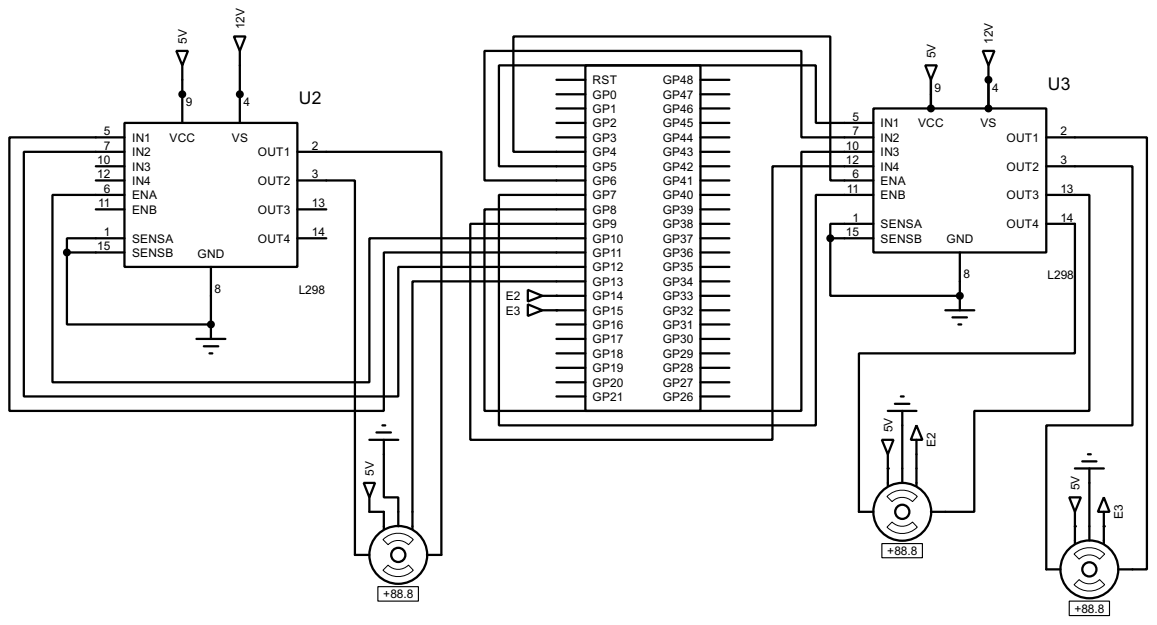
[picture p46: page 1]
