angelaAceroh/Robotica-2026/Ensabladores/Ensamblador 3 /Software/src/scara_kinematics/scara_kinematics/estilo.py

"""Colores de la ventana del brazo.

Estaban en panel.py; al quedarse brazo_hw como unica interfaz se mueven aqui
para que no dependa de un modulo que ya no existe. Son los mismos valores, asi
que la ventana se ve igual que antes.
"""
FONDO = '#eef0f4'
PAPEL = '#ffffff'
TINTA = '#1f2430'
SUAVE = '#79808f'
REJILLA = '#e4e7ee'
VERDE = '#1a9e5c'
ROJO = '#cc3d33'
AZUL = '#2f6fd0'
NARANJA = '#e08a1e'
BORDE = '#ccd1db'
